ConstStar/couple-pointing/document/BOM.xlsx

名称 | 数量 | 参考单价 | 链接 | 备注
GT-U8 加陶瓷有源天线 | 2 | 27 | https://m.tb.cn/h.5SYAljR?tk=DtFtWYdv3TI
ESP-01S | 2 | 5.2 | https://m.tb.cn/h.56ajSyP?tk=Hb25WYdEAWk
9.6寸oled白色 | 2 | 8.9 | https://m.tb.cn/h.56LfTw5?tk=LAS3WYdDNA2
4P单排母座 | 2 | 0.09 | https://m.tb.cn/h.56aPbTV?tk=eDHuWYdDJSK | 劲量多买点
5P单排母座 | 4 | 0.1 | https://m.tb.cn/h.56aPbTV?tk=eDHuWYdDJSK | 劲量多买点
6P单排母座 | 2 | 0.1 | https://m.tb.cn/h.56aPbTV?tk=eDHuWYdDJSK | 劲量多买点
20P单排母座 | 4 | 0.2 | https://m.tb.cn/h.56aPbTV?tk=eDHuWYdDJSK | 劲量多买点
100R（100只） | 1 | 2 | https://m.tb.cn/h.56LTxyy?tk=Aw1OWYdydVf
2*4P双排母座 | 2 | 0.12 | https://m.tb.cn/h.5S1cF6f?tk=xGd6WYdyqOQ | 劲量多买点
433mhz天线 ipex | 2 | 1.7 | https://m.tb.cn/h.5hUp1pE?tk=2Qi6WYdyD6n
stm32f103c8t6 进口芯片 | 2 | 10.6 | https://m.tb.cn/h.56LSMIl?tk=assRWYdzhoQ
HC-14初学者套餐(模块+测试架HC-T | 1 | 12.8 | https://m.tb.cn/h.56aoj8Z?tk=z3ofWYW0Fml
HMC5883L | 2 | 10.19 | https://m.tb.cn/h.5S1VOxm?tk=cf8qWYWYIL7
LED白光 | 16 | 0.03 | https://m.tb.cn/h.56Lr3fv?tk=pCyYWYWg8ZX | 劲量多买点
这些都是一对设备的数量！！！
