ConstStar/couple-pointing/document/Schematic.pdf

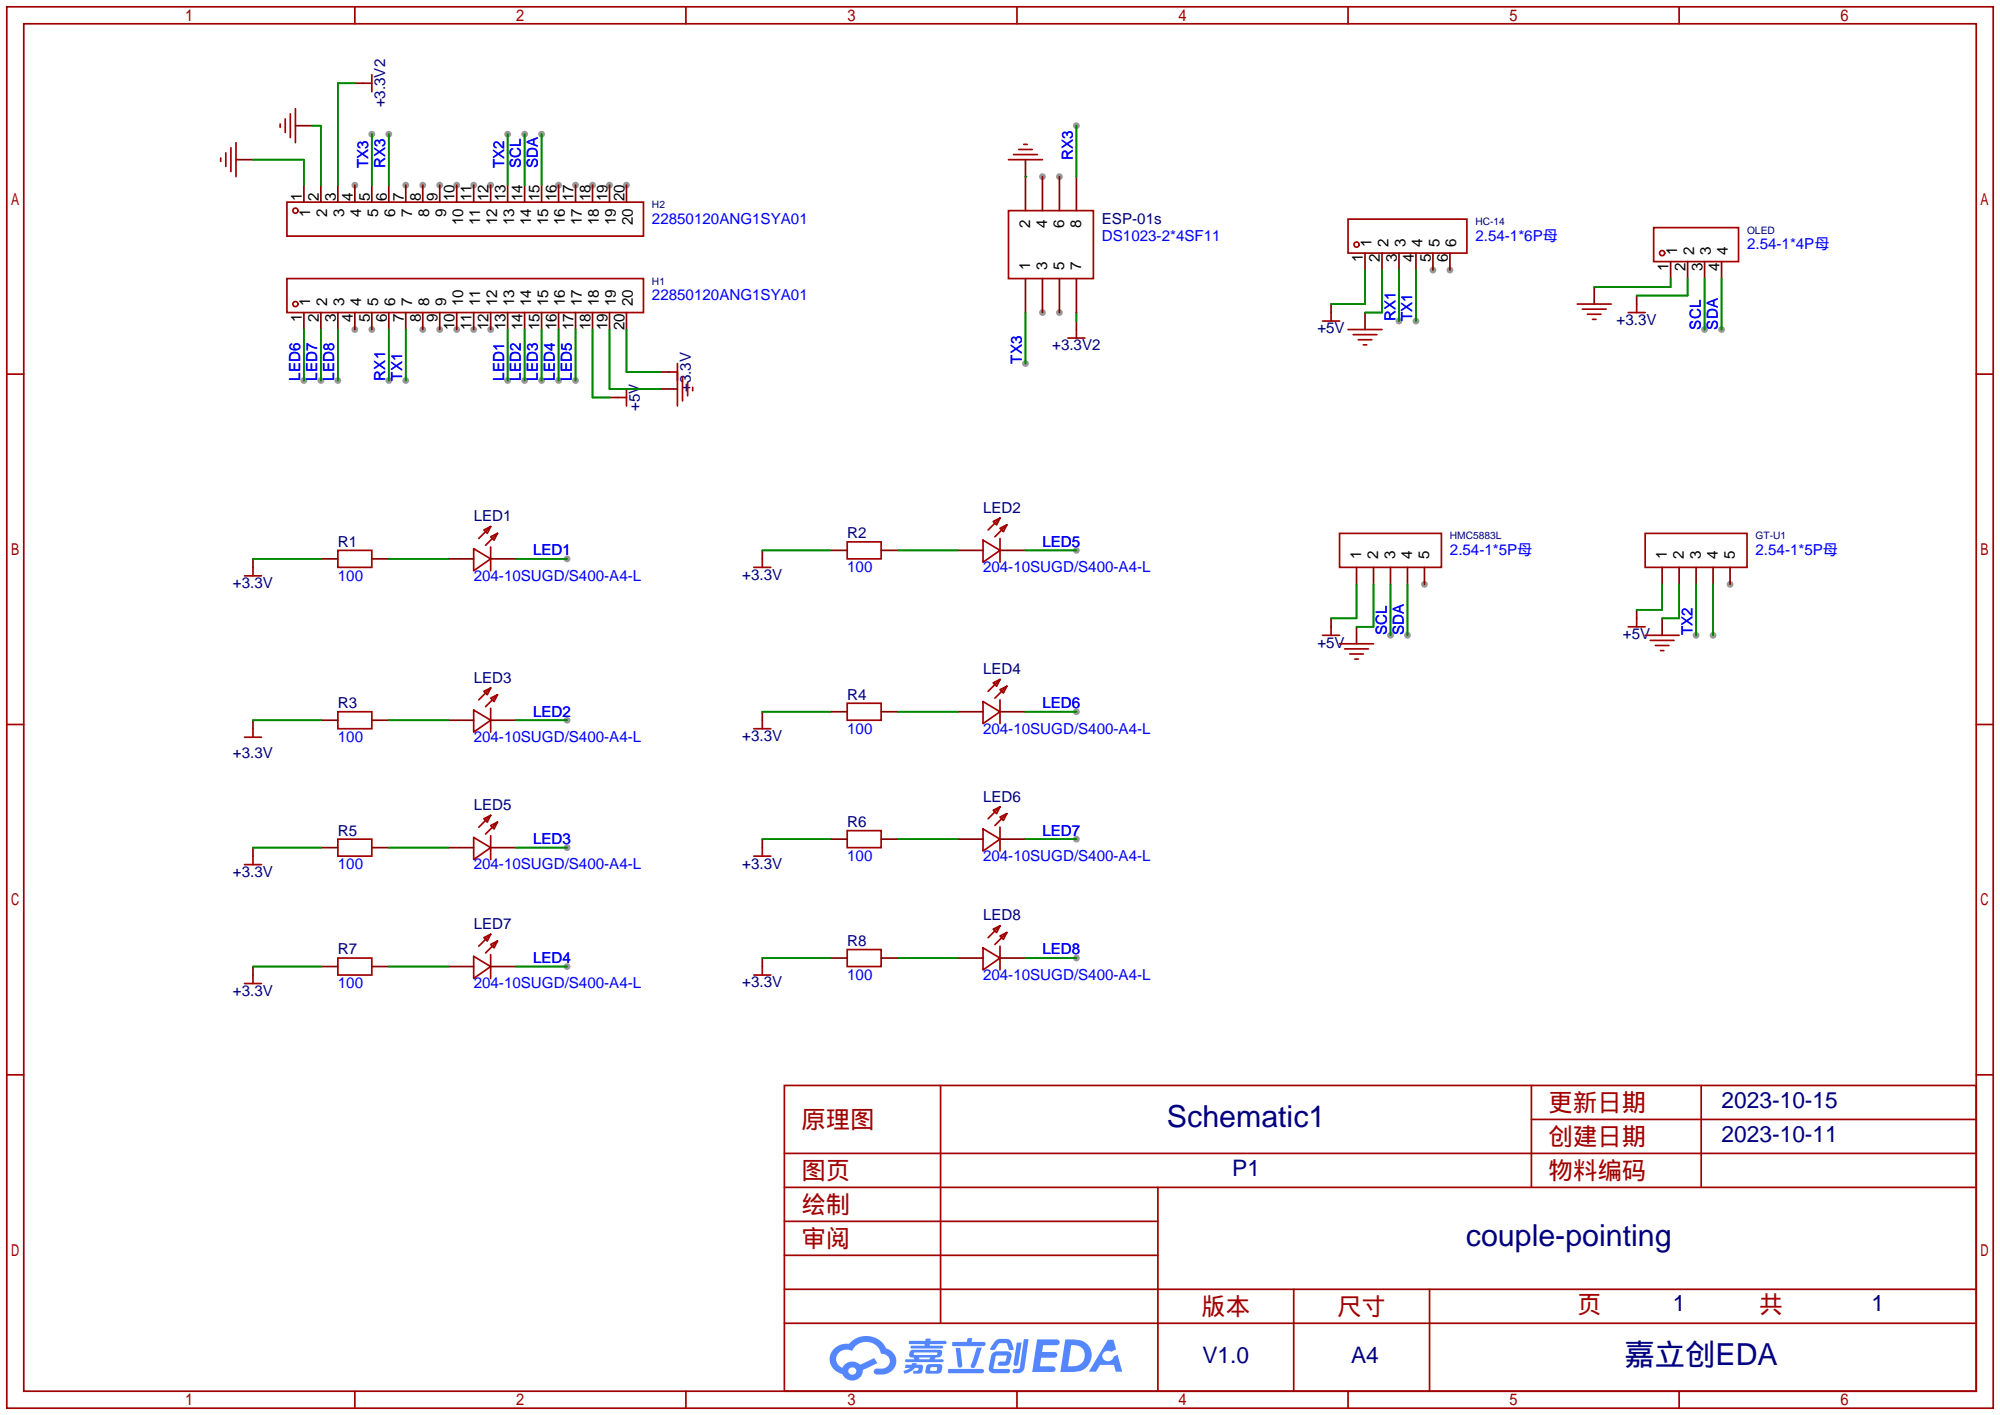
[picture p3: page 1]
