ConstStar/couple-pointing/(list of files, drawings)

Other design files:
document/couple-pointing.eprj
